Polar-Slater/soot_sensor/TI based/hardware/perfboard-soldering/soldering-plan.png

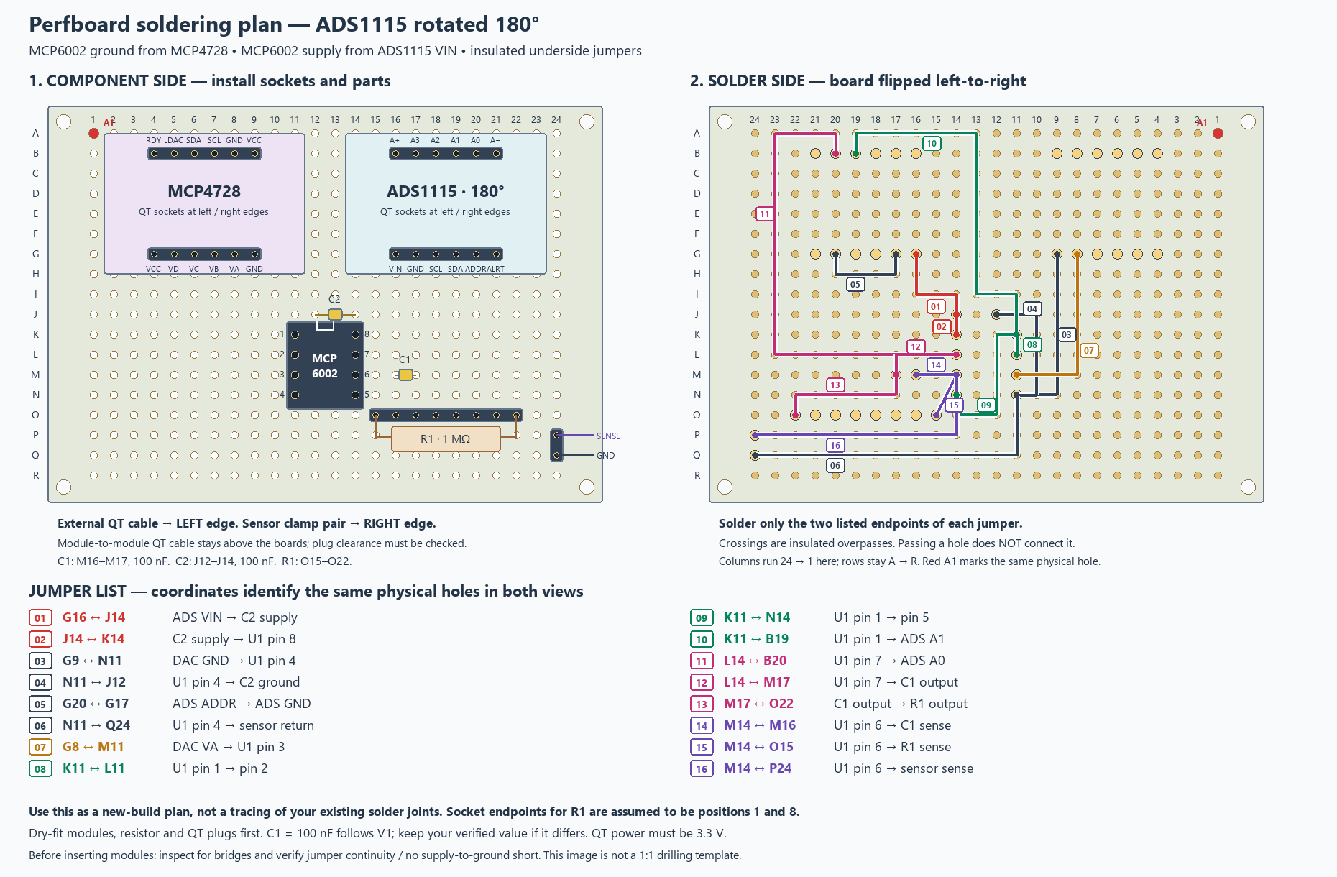
TI based/hardware/perfboard-soldering/soldering-plan.png
