Polar-Slater/soot_sensor/TI based/hardware/sensor-wiring-latest.png

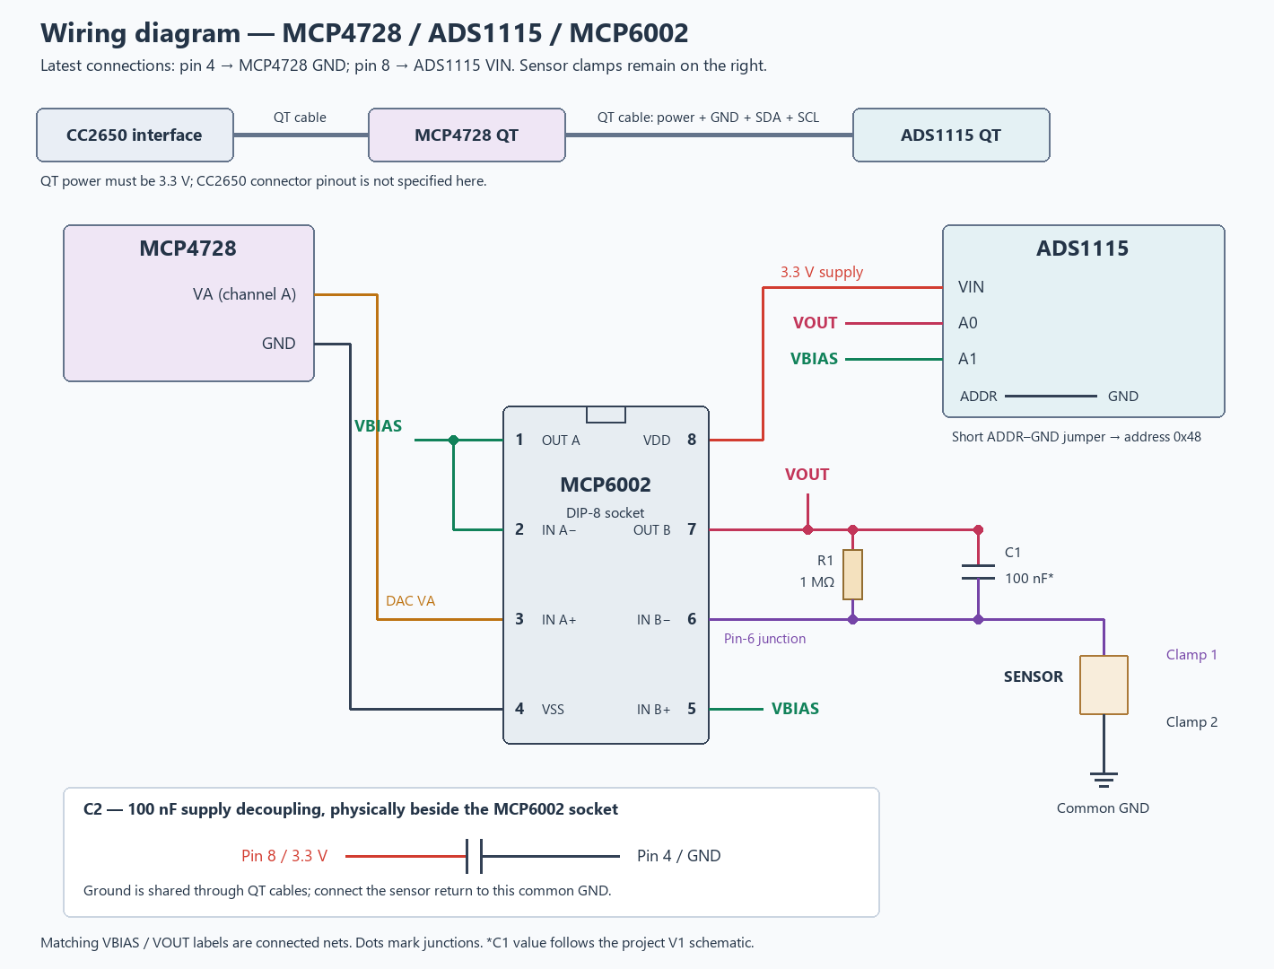
TI based/hardware/sensor-wiring-latest.png
