Polar-Slater/soot_sensor/ESP32 based/src/soot_resistance.cpp

/* Calibration inputs in ohms: replace labels with measured resistor values. */
#define SOOT_FEEDBACK_S1_OHMS               100.0f
#define SOOT_FEEDBACK_S2_OHMS               1000.0f
#define SOOT_FEEDBACK_S3_OHMS               10000.0f
#define SOOT_FEEDBACK_S4_OHMS               100000.0f
#define SOOT_FEEDBACK_S5_OHMS               1000000.0f

/* Optional measured series-switch corrections; zero means uncalibrated. */
#define SOOT_SWITCH_S1_OHMS                 0.0f
#define SOOT_SWITCH_S2_OHMS                 0.0f
#define SOOT_SWITCH_S3_OHMS                 0.0f
#define SOOT_SWITCH_S4_OHMS                 0.0f
#define SOOT_SWITCH_S5_OHMS                 0.0f

#include "soot_resistance.h"

#include <float.h>
#include <stddef.h>
#include <string.h>

#include <Arduino.h>

/* Default seven-bit addresses. */
#define MCP4728_DEFAULT_ADDRESS             0x60u
#define ADS1115_DEFAULT_ADDRESS             0x48u
#define ADG728_DEFAULT_ADDRESS              0x4Cu

/* MCP4728 settings used for channel A. */
#define MCP4728_INTERNAL_REFERENCE_VOLTS    2.048f
#define MCP4728_DAC_STEPS                   4096.0f
#define MCP4728_MULTI_WRITE_CHANNEL_A       0x40u
#define MCP4728_INTERNAL_REF_NORMAL_GAIN_1  0x80u

/* ADS1115 register pointers. */
#define ADS1115_REG_CONVERSION              0x00u
#define ADS1115_REG_CONFIG                  0x01u

/* ADS1115 configuration fields. */
#define ADS1115_OS_START_SINGLE             0x8000u
#define ADS1115_OS_CONVERSION_READY         0x8000u
#define ADS1115_MUX_AIN0_AIN1               0x0000u
#define ADS1115_MUX_AIN1_GND                0x5000u
#define ADS1115_PGA_4_096V                  0x0200u
#define ADS1115_MODE_SINGLE_SHOT            0x0100u
#define ADS1115_DATA_RATE_128_SPS           0x0080u
#define ADS1115_COMPARATOR_DISABLED         0x0003u
#define ADS1115_CONFIG_COMMON               \
    (ADS1115_OS_START_SINGLE | ADS1115_PGA_4_096V | \
     ADS1115_MODE_SINGLE_SHOT | ADS1115_DATA_RATE_128_SPS | \
     ADS1115_COMPARATOR_DISABLED)

/* At +/-4.096 V full-scale, each signed ADS1115 count represents 125 uV. */
#define ADS1115_VOLTS_PER_COUNT             0.000125f
#define ADS1115_NEAR_FULL_SCALE_CODE        32700
#define ADS1115_READY_POLL_LIMIT            25u
#define ADS1115_READY_POLL_DELAY_MS         1u

#define SOOT_DEFAULT_FEEDBACK_SETTLE_MS     100u
#define SOOT_DEFAULT_BIAS_VOLTS             1.000f
#define SOOT_DEFAULT_MIN_BIAS_VOLTS         0.800f
#define SOOT_DEFAULT_MAX_BIAS_VOLTS         1.200f
#define SOOT_DEFAULT_MIN_DELTA_VOLTS        0.0005f
#define SOOT_DEFAULT_ANALOG_SUPPLY_VOLTS    3.300f
#define SOOT_DEFAULT_SAMPLE_COUNT           16u
#define SOOT_MAX_SAMPLE_COUNT               256u
#define SOOT_OUTPUT_RAIL_MARGIN_VOLTS       0.300f /* 3.0 V cutoff at 3.3 V supply. */

static void sleepMilliseconds(uint32_t milliseconds)
{
    delay(milliseconds);
}

static bool i2cTransfer(TwoWire *wire,
                        uint8_t address,
                        const void *writeBuffer,
                        size_t writeCount,
                        void *readBuffer,
                        size_t readCount)
{
    if (writeCount != 0u) {
        wire->beginTransmission(address);
        const size_t written = wire->write(
            static_cast<const uint8_t *>(writeBuffer), writeCount);
        // Always end the transmission to release Wire's transaction lock.
        const uint8_t error = wire->endTransmission(
            (readCount == 0u) || (written != writeCount));
        if ((written != writeCount) || (error != 0u)) {
            return false;
        }
    }
    if (readCount != 0u) {
        // A preceding endTransmission(false) requests a repeated START.
        const size_t received = wire->requestFrom(address, readCount, true);
        if (received != readCount) {
            while (wire->available() > 0) { (void)wire->read(); }
            return false;
        }
        uint8_t *bytes = static_cast<uint8_t *>(readBuffer);
        for (size_t index = 0u; index < readCount; ++index) {
            const int value = wire->read();
            if (value < 0) { return false; }
            bytes[index] = static_cast<uint8_t>(value);
        }
    }
    return true;
}

/* At 1 Mohm and 0.1 uF, ten nominal RC time constants are 1000 ms. */
static void waitForFeedback(const SootResistance *device)
{
    uint32_t delay_ms = device->config.feedback_settle_ms;
    if ((device->active_range == 4u) && (delay_ms < 1000u)) {
        delay_ms = 1000u;
    }
    sleepMilliseconds(delay_ms);
}

static float effectiveFeedback(const SootResistance *device, uint8_t range)
{
    return device->config.feedback_resistance_ohms[range] +
           device->config.switch_resistance_ohms[range];
}

static SootResistance_Status verifyFeedback(SootResistance *device,
                                             uint8_t mask)
{
    uint8_t readback;

    if (!i2cTransfer(device->config.i2c, device->config.adg728_address,
                     NULL, 0u, &readback, 1u)) {
        device->initialized = false; /* Feedback state is unknown; reinitialize. */
        return SOOT_RESISTANCE_STATUS_SWITCH_I2C_ERROR;
    }
    if (readback != mask) {
        device->initialized = false;
        return SOOT_RESISTANCE_STATUS_SWITCH_STATE_ERROR;
    }
    return SOOT_RESISTANCE_STATUS_OK;
}

static SootResistance_Status selectFeedback(SootResistance *device,
                                             uint8_t range)
{
    uint8_t mask = (uint8_t)(1u << range);
    SootResistance_Status status;

    /* One data byte, no register pointer. Hardware provides break-before-make. */
    if (!i2cTransfer(device->config.i2c, device->config.adg728_address,
                     &mask, 1u, NULL, 0u)) {
        device->initialized = false;
        return SOOT_RESISTANCE_STATUS_SWITCH_I2C_ERROR;
    }
    status = verifyFeedback(device, mask);
    if (status != SOOT_RESISTANCE_STATUS_OK) {
        return status;
    }
    device->active_range = range;
    waitForFeedback(device);
    return SOOT_RESISTANCE_STATUS_OK;
}

static bool ads1115ReadRegister(SootResistance *device,
                                uint8_t registerAddress,
                                uint16_t *value)
{
    uint8_t writeBuffer[1];
    uint8_t readBuffer[2];

    writeBuffer[0] = registerAddress;
    if (!i2cTransfer(device->config.i2c,
                     device->config.ads1115_address,
                     writeBuffer,
                     sizeof(writeBuffer),
                     readBuffer,
                     sizeof(readBuffer))) {
        return false;
    }

    *value = ((uint16_t)readBuffer[0] << 8) | (uint16_t)readBuffer[1];
    return true;
}

static bool ads1115WriteConfig(SootResistance *device, uint16_t configWord)
{
    uint8_t writeBuffer[3];

    writeBuffer[0] = ADS1115_REG_CONFIG;
    writeBuffer[1] = (uint8_t)(configWord >> 8);
    writeBuffer[2] = (uint8_t)(configWord & 0xFFu);

    return i2cTransfer(device->config.i2c,
                       device->config.ads1115_address,
                       writeBuffer,
                       sizeof(writeBuffer),
                       NULL,
                       0u);
}

static SootResistance_Status ads1115ReadConversion(SootResistance *device,
                                                    uint16_t mux,
                                                    int16_t *rawCode)
{
    uint16_t configWord;
    uint16_t conversionWord;
    uint16_t poll;

    configWord = ADS1115_CONFIG_COMMON | mux;
    if (!ads1115WriteConfig(device, configWord)) {
        return SOOT_RESISTANCE_STATUS_ADC_I2C_ERROR;
    }

    /*
     * The ADS1115 takes about 7.8 ms at 128 samples/s. Polling OS allows this
     * function to tolerate scheduler timing changes without reading stale data.
     */
    for (poll = 0u; poll < ADS1115_READY_POLL_LIMIT; ++poll) {
        sleepMilliseconds(ADS1115_READY_POLL_DELAY_MS);
        if (!ads1115ReadRegister(device, ADS1115_REG_CONFIG, &configWord)) {
            return SOOT_RESISTANCE_STATUS_ADC_I2C_ERROR;
        }
        if ((configWord & ADS1115_OS_CONVERSION_READY) != 0u) {
            break;
        }
    }

    if (poll == ADS1115_READY_POLL_LIMIT) {
        return SOOT_RESISTANCE_STATUS_ADC_TIMEOUT;
    }

    if (!ads1115ReadRegister(device,
                             ADS1115_REG_CONVERSION,
                             &conversionWord)) {
        return SOOT_RESISTANCE_STATUS_ADC_I2C_ERROR;
    }

    *rawCode = (int16_t)conversionWord;
    return SOOT_RESISTANCE_STATUS_OK;
}

static SootResistance_Status writeMcp4728ChannelA(SootResistance *device)
{
    uint8_t writeBuffer[3];
    uint16_t dacCode;
    float unroundedCode;

    /*
     * Internal VREF = 2.048 V, gain = 1:
     * DAC code = requested voltage * 4096 / 2.048.
     * A 1.000 V request therefore produces code 2000 exactly.
     */
    unroundedCode = device->config.requested_bias_volts *
                    MCP4728_DAC_STEPS /
                    MCP4728_INTERNAL_REFERENCE_VOLTS;
    dacCode = (uint16_t)(unroundedCode + 0.5f);
    if (dacCode > 4095u) {
        dacCode = 4095u;
    }

    /* Multi-write channel A, update immediately, normal mode, gain = 1. */
    writeBuffer[0] = MCP4728_MULTI_WRITE_CHANNEL_A;
    writeBuffer[1] = MCP4728_INTERNAL_REF_NORMAL_GAIN_1 |
                     (uint8_t)((dacCode >> 8) & 0x0Fu);
    writeBuffer[2] = (uint8_t)(dacCode & 0xFFu);

    if (!i2cTransfer(device->config.i2c,
                     device->config.mcp4728_address,
                     writeBuffer,
                     sizeof(writeBuffer),
                     NULL,
                     0u)) {
        return SOOT_RESISTANCE_STATUS_DAC_I2C_ERROR;
    }

    /* MCP4728 settling is much shorter; 1 ms is deliberately conservative. */
    sleepMilliseconds(1u);
    return SOOT_RESISTANCE_STATUS_OK;
}

void SootResistance_configDefaults(SootResistance_Config *config,
                                   TwoWire *sharedWire)
{
    if (config == NULL) {
        return;
    }

    memset(config, 0, sizeof(*config));
    config->i2c = sharedWire;
    config->mcp4728_address = MCP4728_DEFAULT_ADDRESS;
    config->ads1115_address = ADS1115_DEFAULT_ADDRESS;
    config->adg728_address = ADG728_DEFAULT_ADDRESS;
    config->feedback_resistance_ohms[0] = SOOT_FEEDBACK_S1_OHMS;
    config->feedback_resistance_ohms[1] = SOOT_FEEDBACK_S2_OHMS;
    config->feedback_resistance_ohms[2] = SOOT_FEEDBACK_S3_OHMS;
    config->feedback_resistance_ohms[3] = SOOT_FEEDBACK_S4_OHMS;
    config->feedback_resistance_ohms[4] = SOOT_FEEDBACK_S5_OHMS;
    config->switch_resistance_ohms[0] = SOOT_SWITCH_S1_OHMS;
    config->switch_resistance_ohms[1] = SOOT_SWITCH_S2_OHMS;
    config->switch_resistance_ohms[2] = SOOT_SWITCH_S3_OHMS;
    config->switch_resistance_ohms[3] = SOOT_SWITCH_S4_OHMS;
    config->switch_resistance_ohms[4] = SOOT_SWITCH_S5_OHMS;
    config->feedback_settle_ms = SOOT_DEFAULT_FEEDBACK_SETTLE_MS;
    config->requested_bias_volts = SOOT_DEFAULT_BIAS_VOLTS;
    config->minimum_valid_bias_volts = SOOT_DEFAULT_MIN_BIAS_VOLTS;
    config->maximum_valid_bias_volts = SOOT_DEFAULT_MAX_BIAS_VOLTS;
    config->minimum_valid_delta_volts = SOOT_DEFAULT_MIN_DELTA_VOLTS;
    config->analog_supply_volts = SOOT_DEFAULT_ANALOG_SUPPLY_VOLTS;
    config->sample_count = SOOT_DEFAULT_SAMPLE_COUNT;
}

static bool validConfig(const SootResistance_Config *config)
{
    uint8_t range;
    float previous = 0.0f;
    float effective;

    /* Positive bounded comparisons also reject NaN and infinity. */
    if ((config == NULL) || (config->i2c == NULL) ||
        (config->adg728_address < 0x4Cu) || (config->adg728_address > 0x4Fu) ||
        (config->mcp4728_address > 0x7Fu) ||
        (config->ads1115_address > 0x7Fu) ||
        !(config->requested_bias_volts > 0.0f) ||
        !(config->requested_bias_volts < MCP4728_INTERNAL_REFERENCE_VOLTS) ||
        !(config->minimum_valid_bias_volts > 0.0f) ||
        !(config->minimum_valid_bias_volts <= config->requested_bias_volts) ||
        !(config->maximum_valid_bias_volts >= config->requested_bias_volts) ||
        !(config->analog_supply_volts <= 3.6f) ||
        !(config->analog_supply_volts >= 2.7f) ||
        !(config->maximum_valid_bias_volts < config->analog_supply_volts -
          SOOT_OUTPUT_RAIL_MARGIN_VOLTS) ||
        !(config->minimum_valid_delta_volts > 0.0f) ||
        !(config->minimum_valid_delta_volts < config->analog_supply_volts -
          config->maximum_valid_bias_volts - SOOT_OUTPUT_RAIL_MARGIN_VOLTS) ||
        (config->feedback_settle_ms == 0u) ||
        (config->feedback_settle_ms > 60000u) ||
        (config->sample_count == 0u) ||
        (config->sample_count > SOOT_MAX_SAMPLE_COUNT)) {
        return false;
    }
    for (range = 0u; range < SOOT_RESISTANCE_RANGE_COUNT; ++range) {
        if (!(config->feedback_resistance_ohms[range] > 0.0f) ||
            !(config->switch_resistance_ohms[range] >= 0.0f)) {
            return false;
        }
        effective = config->feedback_resistance_ohms[range] +
                    config->switch_resistance_ohms[range];
        if (!(effective > previous) || !(effective <= FLT_MAX / 10000.0f)) {
            return false;
        }
        previous = effective;
    }
    return true;
}

SootResistance_Status SootResistance_init(
    SootResistance *device,
    const SootResistance_Config *config)
{
    uint16_t adsConfig;
    SootResistance_Status status;

    if (device == NULL) {
        return SOOT_RESISTANCE_STATUS_INVALID_ARGUMENT;
    }
    device->initialized = false;
    if (!validConfig(config)) {
        return SOOT_RESISTANCE_STATUS_INVALID_ARGUMENT;
    }

    device->config = *config;

    /* Start with the highest feedback resistance before applying bias. */
    status = selectFeedback(device, SOOT_RESISTANCE_RANGE_COUNT - 1u);
    if (status != SOOT_RESISTANCE_STATUS_OK) {
        return status;
    }
    status = writeMcp4728ChannelA(device);
    if (status != SOOT_RESISTANCE_STATUS_OK) {
        return status;
    }
    waitForFeedback(device);

    /* Reading the configuration register verifies the ADS1115 address/ACK. */
    if (!ads1115ReadRegister(device, ADS1115_REG_CONFIG, &adsConfig)) {
        return SOOT_RESISTANCE_STATUS_ADC_I2C_ERROR;
    }

    device->initialized = true;
    return SOOT_RESISTANCE_STATUS_OK;
}

SootResistance_Status SootResistance_setBias(SootResistance *device)
{
    SootResistance_Status status;
    if (device == NULL) {
        return SOOT_RESISTANCE_STATUS_INVALID_ARGUMENT;
    }
    if (!device->initialized) {
        return SOOT_RESISTANCE_STATUS_NOT_INITIALIZED;
    }

    status = writeMcp4728ChannelA(device);
    if (status == SOOT_RESISTANCE_STATUS_OK) {
        waitForFeedback(device);
    } else {
        device->initialized = false;
    }
    return status;
}

static SootResistance_Status readSelectedFeedback(
    SootResistance *device,
    SootResistance_Measurement *measurement)
{
    int32_t biasCodeSum;
    int32_t deltaCodeSum;
    int16_t biasCode;
    int16_t deltaCode;
    uint16_t sample;
    bool saturated;
    SootResistance_Status status;

    if ((device == NULL) || (measurement == NULL)) {
        return SOOT_RESISTANCE_STATUS_INVALID_ARGUMENT;
    }
    if (!device->initialized) {
        return SOOT_RESISTANCE_STATUS_NOT_INITIALIZED;
    }

    memset(measurement, 0, sizeof(*measurement));
    measurement->feedback_channel = (uint8_t)(device->active_range + 1u);
    measurement->feedback_resistance_ohms =
        effectiveFeedback(device, device->active_range);
    biasCodeSum = 0;
    deltaCodeSum = 0;
    saturated = false;

    for (sample = 0u; sample < device->config.sample_count; ++sample) {
        /* A1 is the buffered DAC bias voltage. */
        status = ads1115ReadConversion(device, ADS1115_MUX_AIN1_GND,
                                       &biasCode);
        if (status != SOOT_RESISTANCE_STATUS_OK) {
            return status;
        }

        /* A0 - A1 is the voltage developed across the feedback resistor. */
        status = ads1115ReadConversion(device, ADS1115_MUX_AIN0_AIN1,
                                       &deltaCode);
        if (status != SOOT_RESISTANCE_STATUS_OK) {
            return status;
        }

        biasCodeSum += (int32_t)biasCode;
        deltaCodeSum += (int32_t)deltaCode;

        if ((biasCode >= ADS1115_NEAR_FULL_SCALE_CODE) ||
            (biasCode <= -ADS1115_NEAR_FULL_SCALE_CODE) ||
            (deltaCode >= ADS1115_NEAR_FULL_SCALE_CODE) ||
            (deltaCode <= -ADS1115_NEAR_FULL_SCALE_CODE)) {
            saturated = true;
        }
    }

    /* Detect a switch reset/state change during the conversion sequence. */
    status = verifyFeedback(device, (uint8_t)(1u << device->active_range));
    if (status != SOOT_RESISTANCE_STATUS_OK) {
        return status;
    }

    measurement->average_bias_code =
        (int16_t)(biasCodeSum / (int32_t)device->config.sample_count);
    measurement->average_delta_code =
        (int16_t)(deltaCodeSum / (int32_t)device->config.sample_count);
    measurement->bias_volts =
        (float)measurement->average_bias_code * ADS1115_VOLTS_PER_COUNT;
    measurement->delta_volts =
        (float)measurement->average_delta_code * ADS1115_VOLTS_PER_COUNT;
    measurement->output_volts = measurement->bias_volts +
                                measurement->delta_volts;
    measurement->current_amps = measurement->delta_volts /
                                measurement->feedback_resistance_ohms;

    if ((measurement->bias_volts <
         device->config.minimum_valid_bias_volts) ||
        (measurement->bias_volts >
         device->config.maximum_valid_bias_volts)) {
        return SOOT_RESISTANCE_STATUS_BIAS_OUT_OF_RANGE;
    }

    if (saturated ||
        (measurement->output_volts >=
         (device->config.analog_supply_volts -
          SOOT_OUTPUT_RAIL_MARGIN_VOLTS))) {
        return SOOT_RESISTANCE_STATUS_ADC_SATURATED;
    }

    /*
     * A zero or negative delta means an open circuit, a reversed current,
     * excessive resistance, or wiring outside the expected topology.  The
     * threshold prevents unstable division when the signal is near ADC noise.
     */
    if (measurement->delta_volts <=
        device->config.minimum_valid_delta_volts) {
        return SOOT_RESISTANCE_STATUS_OPEN_OR_OUT_OF_RANGE;
    }

    /*
     * At the TIA summing node:
     *   I_sensor = V_bias / R_sensor
     *   V_output - V_bias = I_sensor * R_feedback
     * Therefore R_sensor = R_feedback * V_bias / (V_output - V_bias).
     */
    measurement->resistance_ohms =
        measurement->feedback_resistance_ohms *
        measurement->bias_volts /
        measurement->delta_volts;

    return SOOT_RESISTANCE_STATUS_OK;
}

SootResistance_Status SootResistance_read(
    SootResistance *device,
    SootResistance_Measurement *measurement)
{
    uint8_t range;
    SootResistance_Status status;

    if (measurement == NULL) {
        return SOOT_RESISTANCE_STATUS_INVALID_ARGUMENT;
    }
    memset(measurement, 0, sizeof(*measurement));
    if (device == NULL) {
        return SOOT_RESISTANCE_STATUS_INVALID_ARGUMENT;
    }
    if (!device->initialized) {
        return SOOT_RESISTANCE_STATUS_NOT_INITIALIZED;
    }

    /* Try S5, S4, S3, S2, S1; retain the highest gain that is not saturated. */
    range = SOOT_RESISTANCE_RANGE_COUNT;
    while (range > 0u) {
        --range;
        memset(measurement, 0, sizeof(*measurement));
        status = selectFeedback(device, range);
        if (status != SOOT_RESISTANCE_STATUS_OK) {
            return status;
        }
        status = readSelectedFeedback(device, measurement);
        /* Low signals cannot improve at lower gain; other faults stop the scan. */
        if ((status != SOOT_RESISTANCE_STATUS_ADC_SATURATED) || (range == 0u)) {
            return status;
        }
    }
    return SOOT_RESISTANCE_STATUS_OPEN_OR_OUT_OF_RANGE;
}

const char *SootResistance_statusString(SootResistance_Status status)
{
    switch (status) {
    case SOOT_RESISTANCE_STATUS_OK:
        return "OK";
    case SOOT_RESISTANCE_STATUS_INVALID_ARGUMENT:
        return "INVALID_ARGUMENT";
    case SOOT_RESISTANCE_STATUS_NOT_INITIALIZED:
        return "NOT_INITIALIZED";
    case SOOT_RESISTANCE_STATUS_DAC_I2C_ERROR:
        return "DAC_I2C_ERROR";
    case SOOT_RESISTANCE_STATUS_ADC_I2C_ERROR:
        return "ADC_I2C_ERROR";
    case SOOT_RESISTANCE_STATUS_ADC_TIMEOUT:
        return "ADC_TIMEOUT";
    case SOOT_RESISTANCE_STATUS_ADC_SATURATED:
        return "ADC_SATURATED";
    case SOOT_RESISTANCE_STATUS_BIAS_OUT_OF_RANGE:
        return "BIAS_OUT_OF_RANGE";
    case SOOT_RESISTANCE_STATUS_OPEN_OR_OUT_OF_RANGE:
        return "OPEN_OR_OUT_OF_RANGE";
    case SOOT_RESISTANCE_STATUS_SWITCH_I2C_ERROR:
        return "SWITCH_I2C_ERROR";
    case SOOT_RESISTANCE_STATUS_SWITCH_STATE_ERROR:
        return "SWITCH_STATE_ERROR";
    default:
        return "UNKNOWN_STATUS";
    }
}
