Polar-Slater/soot_sensor/ESP32 based/tests/test_soot_resistance.cpp

/* ESP32 Wire simulation and static ideal TIA; not physical board validation. */
#include "soot_resistance.h"
#include <assert.h>
#include <math.h>
#include <stdio.h>
#include <string.h>

static uint32_t slept_ticks;
static uint8_t selected_mask, selections[16];
static unsigned selection_count, adc_reads, switch_reads;
static uint16_t adc_config;
static float sensor_ohms, bias_volts, feedback[SOOT_RESISTANCE_RANGE_COUNT];
static int fail_address, mismatch_on_read, saturation_mask;
static bool adc_timeout;
static float maximum_delta_volts;

void delay(unsigned long milliseconds)
{
    assert(milliseconds > 0u);
    slept_ticks += static_cast<uint32_t>(milliseconds);
}
struct BusTransaction {
    uint8_t slaveAddress;
    void *writeBuf;
    size_t writeCount;
    void *readBuf;
    size_t readCount;
};

static bool modelTransfer(BusTransaction *t)
{
    uint8_t *w = (uint8_t *)t->writeBuf;
    uint8_t *r = (uint8_t *)t->readBuf;
    uint16_t value;
    unsigned range;
    float delta;
    if ((int)t->slaveAddress == fail_address) { return false; }
    if (t->slaveAddress == 0x4Cu) {
        if (t->writeCount != 0u) {
            assert(t->writeCount == 1u && t->readCount == 0u);
            assert(w[0] == 1u || w[0] == 2u || w[0] == 4u || w[0] == 8u || w[0] == 16u);
            assert(selection_count < sizeof(selections));
            selected_mask = w[0];
            selections[selection_count++] = w[0];
        } else {
            assert(t->readCount == 1u);
            ++switch_reads;
            r[0] = ((int)switch_reads == mismatch_on_read) ? 0u : selected_mask;
        }
        return true;
    }
    if (t->slaveAddress == 0x60u) {
        assert(selected_mask != 0u); /* Feedback must precede applying bias. */
        assert(t->writeCount == 3u && t->readCount == 0u);
        assert(w[0] == 0x40u && w[1] == 0x87u && w[2] == 0xD0u);
        return true;
    }
    assert(t->slaveAddress == 0x48u);
    if (t->writeCount == 3u) {
        assert(t->readCount == 0u && w[0] == 1u);
        adc_config = (uint16_t)(((uint16_t)w[1] << 8) | w[2]);
        assert((adc_config & 0x8FFFu) == 0x8383u);
        return true;
    }
    assert(t->writeCount == 1u && t->readCount == 2u);
    if (w[0] == 1u) {
        value = adc_timeout ? (uint16_t)(adc_config & ~0x8000u) :
                             (uint16_t)(adc_config | 0x8000u);
    } else {
        assert(w[0] == 0u);
        ++adc_reads;
        if ((adc_config & 0x7000u) == 0x5000u) {
            value = (uint16_t)(int16_t)lroundf(bias_volts / 0.000125f);
        } else {
            assert((adc_config & 0x7000u) == 0u);
            for (range = 0u; selected_mask != (1u << range); ++range) {
                assert(range < SOOT_RESISTANCE_RANGE_COUNT);
            }
            delta = sensor_ohms == 0.0f ? 3.0f :
                    bias_volts * feedback[range] / sensor_ohms;
            if (selected_mask == saturation_mask || delta > maximum_delta_volts) { delta = maximum_delta_volts; }
            value = (uint16_t)(int16_t)lroundf(delta / 0.000125f);
        }
    }
    r[0] = (uint8_t)(value >> 8);
    r[1] = (uint8_t)value;
    return true;
}

TwoWire Wire;
static uint8_t wireAddress, txBuffer[8], rxBuffer[8];
static size_t txCount, rxCount, rxIndex;
static bool repeatedStart, shortWrite, shortRead, invalidRead;
static unsigned beginCount, repeatedStartCount;

bool TwoWire::begin(int sda, int scl, uint32_t frequency)
{
    assert(sda == 21 && scl == 22 && frequency == 100000u);
    ++beginCount;
    return true;
}
void TwoWire::setTimeOut(uint16_t milliseconds) { assert(milliseconds > 0u); }
void TwoWire::beginTransmission(uint8_t address)
{
    assert(!repeatedStart);
    wireAddress = address;
    txCount = 0u;
}
size_t TwoWire::write(const uint8_t *buffer, size_t count)
{
    assert(count <= sizeof(txBuffer));
    txCount = shortWrite ? count - 1u : count;
    memcpy(txBuffer, buffer, txCount);
    return txCount;
}
uint8_t TwoWire::endTransmission(bool stopBit)
{
    if (shortWrite) {
        assert(stopBit); // A failed buffer write must release the bus lock.
        return 4u;
    }
    if (!stopBit) {
        assert(wireAddress == 0x48u && txCount == 1u);
        repeatedStart = true;
        return 0u;
    }
    BusTransaction t = {wireAddress, txBuffer, txCount, NULL, 0u};
    return modelTransfer(&t) ? 0u : 2u;
}
size_t TwoWire::requestFrom(uint8_t address, size_t count, bool stopBit)
{
    assert(stopBit && count <= sizeof(rxBuffer));
    if (address == 0x48u) {
        assert(repeatedStart && address == wireAddress);
        ++repeatedStartCount;
    } else {
        assert(!repeatedStart && address == 0x4Cu);
    }
    BusTransaction t = {address, txBuffer, repeatedStart ? txCount : 0u, rxBuffer, count};
    repeatedStart = false;
    rxIndex = 0u;
    rxCount = modelTransfer(&t) ? count : 0u;
    if (shortRead && rxCount > 0u) { --rxCount; }
    return rxCount;
}
int TwoWire::available() { return static_cast<int>(rxCount - rxIndex); }
int TwoWire::read()
{
    if (invalidRead || rxIndex >= rxCount) { return -1; }
    return rxBuffer[rxIndex++];
}

static SootResistance_Config reset(void)
{
    SootResistance_Config config;
    SootResistance_configDefaults(&config, &Wire);
    repeatedStart = shortWrite = shortRead = invalidRead = false;
    txCount = rxCount = rxIndex = 0u;
    beginCount = repeatedStartCount = 0u;
    assert(Wire.begin(21, 22, 100000u));
    config.sample_count = 1u;
    selected_mask = 0u;
    selection_count = adc_reads = switch_reads = 0u;
    slept_ticks = 0u;
    adc_config = 0u;
    sensor_ohms = 5000.0f;
    maximum_delta_volts = 2.3f;
    bias_volts = 1.0f;
    fail_address = mismatch_on_read = saturation_mask = -1;
    adc_timeout = false;
    memcpy(feedback, config.feedback_resistance_ohms, sizeof(feedback));
    return config;
}

static void near(float actual, float expected, float relative)
{
    assert(fabsf(actual - expected) <= fabsf(expected) * relative);
}

int main(void)
{
    SootResistance device;
    SootResistance_Config config;
    SootResistance_Measurement result;
    SootResistance_Status status;
    unsigned range;
    unsigned step;
    const float loads[] = {100.0f, 1000.0f, 10000.0f, 100000.0f, 1000000.0f};

    for (range = 0u; range < SOOT_RESISTANCE_RANGE_COUNT; ++range) {
        config = reset();
        config.sample_count = 16u;
        sensor_ohms = loads[range];
        assert(SootResistance_init(&device, &config) == SOOT_RESISTANCE_STATUS_OK);
        assert(selected_mask == 16u && selection_count == 1u);
        assert(SootResistance_read(&device, &result) == SOOT_RESISTANCE_STATUS_OK);
        assert(result.feedback_channel == range + 1u);
        assert(selection_count == 6u - range);
        assert(adc_reads == (5u - range) * 32u);
        for (step = 1u; step < selection_count; ++step) {
            assert(selections[step] == (16u >> (step - 1u)));
        }
        near(result.resistance_ohms, sensor_ohms, 0.001f);
        near(result.current_amps, bias_volts / sensor_ohms, 0.001f);
        near(result.delta_volts, 1.0f, 0.001f);
        assert(slept_ticks >= 3000u + (4u - range) * config.feedback_settle_ms);
    }

    /* Large gain from last call must not persist when the sensor changes. */
    sensor_ohms = 100.0f;
    assert(SootResistance_read(&device, &result) == SOOT_RESISTANCE_STATUS_OK);
    assert(result.feedback_channel == 1u);
    near(result.resistance_ohms, sensor_ohms, 0.001f);
    /* A later high-resistance load must start over at S5, not stay on S1. */
    sensor_ohms = 1000000.0f;
    step = selection_count;
    assert(SootResistance_read(&device, &result) == SOOT_RESISTANCE_STATUS_OK);
    assert(selection_count == step + 1u && selections[step] == 16u);
    assert(result.feedback_channel == 5u);
    near(result.resistance_ohms, sensor_ohms, 0.001f);

    config = reset();
    config.feedback_resistance_ohms[0] = 101.0f;
    config.switch_resistance_ohms[0] = 6.0f;
    feedback[0] = 107.0f;
    sensor_ohms = 107.0f;
    assert(SootResistance_init(&device, &config) == SOOT_RESISTANCE_STATUS_OK);
    assert(SootResistance_read(&device, &result) == SOOT_RESISTANCE_STATUS_OK);
    assert(result.feedback_resistance_ohms == 107.0f);
    near(result.resistance_ohms, sensor_ohms, 0.001f);

    config = reset();
    assert(SootResistance_init(&device, &config) == SOOT_RESISTANCE_STATUS_OK);
    sensor_ohms = INFINITY;
    assert(SootResistance_read(&device, &result) == SOOT_RESISTANCE_STATUS_OPEN_OR_OUT_OF_RANGE);
    assert(result.feedback_channel == 5u && result.resistance_ohms == 0.0f);
    assert(selection_count == 2u && adc_reads == 2u);
    sensor_ohms = 10000000.0f; /* Weak but valid signal remains on S5. */
    assert(SootResistance_read(&device, &result) == SOOT_RESISTANCE_STATUS_OK);
    near(result.resistance_ohms, sensor_ohms, 0.001f);
    assert(result.feedback_channel == 5u && selection_count == 3u);
    sensor_ohms = 0.0f;
    assert(SootResistance_read(&device, &result) == SOOT_RESISTANCE_STATUS_ADC_SATURATED);
    assert(result.feedback_channel == 1u && result.resistance_ohms == 0.0f);
    assert(selection_count == 8u && selections[7] == 1u);

    config = reset();
    sensor_ohms = 1000.0f;
    saturation_mask = 2; /* Unexpected saturation at S2 must continue to S1. */
    assert(SootResistance_init(&device, &config) == SOOT_RESISTANCE_STATUS_OK);
    assert(SootResistance_read(&device, &result) == SOOT_RESISTANCE_STATUS_OK);
    assert(selection_count == 6u && selections[5] == 1u && adc_reads == 10u);
    near(result.resistance_ohms, sensor_ohms, 0.001f);

    /* A 3.155 V output plateau must not be accepted as ~464 ohm on S2. */
    config = reset();
    maximum_delta_volts = 2.155f;
    sensor_ohms = 100.0f;
    assert(SootResistance_init(&device, &config) == SOOT_RESISTANCE_STATUS_OK);
    assert(SootResistance_read(&device, &result) == SOOT_RESISTANCE_STATUS_OK);
    assert(result.feedback_channel == 1u && selection_count == 6u);
    near(result.resistance_ohms, sensor_ohms, 0.001f);

    /* The analog-output cutoff is inclusive; just below it retains S5. */
    config = reset();
    sensor_ohms = 1000000.0f / 2.0f;
    assert(SootResistance_init(&device, &config) == SOOT_RESISTANCE_STATUS_OK);
    assert(SootResistance_read(&device, &result) == SOOT_RESISTANCE_STATUS_OK);
    assert(result.feedback_channel == 4u && selection_count == 3u);
    sensor_ohms = 1000000.0f / 1.999875f;
    assert(SootResistance_read(&device, &result) == SOOT_RESISTANCE_STATUS_OK);
    assert(result.feedback_channel == 5u && selection_count == 4u);

    /* Invalid bias stops immediately even if the output is also saturated. */
    config = reset();
    assert(SootResistance_init(&device, &config) == SOOT_RESISTANCE_STATUS_OK);
    bias_volts = 1.3f;
    assert(SootResistance_read(&device, &result) == SOOT_RESISTANCE_STATUS_BIAS_OUT_OF_RANGE);
    assert(result.resistance_ohms == 0.0f);
    assert(selection_count == 2u && result.feedback_channel == 5u);
    bias_volts = 1.0f;
    adc_timeout = true;
    assert(SootResistance_read(&device, &result) == SOOT_RESISTANCE_STATUS_ADC_TIMEOUT);
    assert(result.resistance_ohms == 0.0f);
    adc_timeout = false;
    fail_address = 0x48;
    assert(SootResistance_read(&device, &result) == SOOT_RESISTANCE_STATUS_ADC_I2C_ERROR);
    assert(result.resistance_ohms == 0.0f);
    fail_address = 0x4C;
    assert(SootResistance_read(&device, &result) == SOOT_RESISTANCE_STATUS_SWITCH_I2C_ERROR);
    assert(!device.initialized && result.resistance_ohms == 0.0f);
    result.resistance_ohms = 123.0f;
    assert(SootResistance_read(&device, &result) == SOOT_RESISTANCE_STATUS_NOT_INITIALIZED);
    assert(result.resistance_ohms == 0.0f);

    config = reset();
    assert(SootResistance_init(&device, &config) == SOOT_RESISTANCE_STATUS_OK);
    mismatch_on_read = 3; /* Init read, selection read, then reset during ADC. */
    assert(SootResistance_read(&device, &result) == SOOT_RESISTANCE_STATUS_SWITCH_STATE_ERROR);
    assert(!device.initialized && result.resistance_ohms == 0.0f);

    config = reset();
    fail_address = 0x60;
    assert(SootResistance_init(&device, &config) == SOOT_RESISTANCE_STATUS_DAC_I2C_ERROR);
    assert(!device.initialized);
    config = reset();
    mismatch_on_read = 1;
    assert(SootResistance_init(&device, &config) == SOOT_RESISTANCE_STATUS_SWITCH_STATE_ERROR);
    assert(!device.initialized && adc_reads == 0u);

    config = reset();
    config.feedback_resistance_ohms[1] = 1.0f;
    assert(SootResistance_init(&device, &config) == SOOT_RESISTANCE_STATUS_INVALID_ARGUMENT);
    config = reset();
    config.feedback_resistance_ohms[0] = NAN;
    assert(SootResistance_init(&device, &config) == SOOT_RESISTANCE_STATUS_INVALID_ARGUMENT);
    config = reset();
    config.switch_resistance_ohms[0] = INFINITY;
    assert(SootResistance_init(&device, &config) == SOOT_RESISTANCE_STATUS_INVALID_ARGUMENT);
    config = reset();
    config.requested_bias_volts = NAN;
    assert(SootResistance_init(&device, &config) == SOOT_RESISTANCE_STATUS_INVALID_ARGUMENT);
    assert(selection_count == 0u);

    config = reset();
    assert(SootResistance_init(&device, &config) == SOOT_RESISTANCE_STATUS_OK);
    slept_ticks = 0u;
    assert(SootResistance_setBias(&device) == SOOT_RESISTANCE_STATUS_OK);
    assert(slept_ticks >= 1000u);
    fail_address = 0x60;
    assert(SootResistance_setBias(&device) == SOOT_RESISTANCE_STATUS_DAC_I2C_ERROR);
    assert(!device.initialized);

    status = SootResistance_read(NULL, &result);
    assert(status == SOOT_RESISTANCE_STATUS_INVALID_ARGUMENT);
    assert(strcmp(SootResistance_statusString(SOOT_RESISTANCE_STATUS_SWITCH_I2C_ERROR),
                  "SWITCH_I2C_ERROR") == 0);
    // Exercise failures specific to the ESP32 Wire adapter.
    config = reset();
    assert(SootResistance_init(&device, &config) == SOOT_RESISTANCE_STATUS_OK);
    assert(beginCount == 1u && repeatedStartCount > 0u);
    shortWrite = true;
    assert(SootResistance_read(&device, &result) == SOOT_RESISTANCE_STATUS_SWITCH_I2C_ERROR);
    assert(!device.initialized && result.resistance_ohms == 0.0f);

    config = reset();
    assert(SootResistance_init(&device, &config) == SOOT_RESISTANCE_STATUS_OK);
    shortRead = true;
    assert(SootResistance_read(&device, &result) == SOOT_RESISTANCE_STATUS_SWITCH_I2C_ERROR);
    assert(rxIndex == rxCount && result.resistance_ohms == 0.0f);

    config = reset();
    assert(SootResistance_init(&device, &config) == SOOT_RESISTANCE_STATUS_OK);
    invalidRead = true;
    assert(SootResistance_read(&device, &result) == SOOT_RESISTANCE_STATUS_SWITCH_I2C_ERROR);
    assert(!device.initialized && result.resistance_ohms == 0.0f);

    puts("PASS: descending ranges, calibration, faults, settling, repeated START, short Wire transfers");
    return 0;
}
