Polar-Slater/soot_sensor/(commit log)

2026-10-27 Add ADG728 automatic feedback resistor selection
2026-10-27 Start feedback auto-ranging at the highest resistance
2026-10-28 Add independently versioned ESP32 resistance acquisition package
2026-10-28 Clarify shared STEMMA QT wiring for the ESP32 circuit
2026-10-31 Add readable ESP32 Serial Monitor output
2026-11-02 Add a 1 Mohm ADG728 S5 feedback range to TI and ESP32
2026-11-06 Lower TI and ESP32 feedback switching cutoff to 3.0 V
